camiloromero01/Micro-Current-Measurement/Pruebas de laboratorio/Corriente_activa_medicion.jpeg

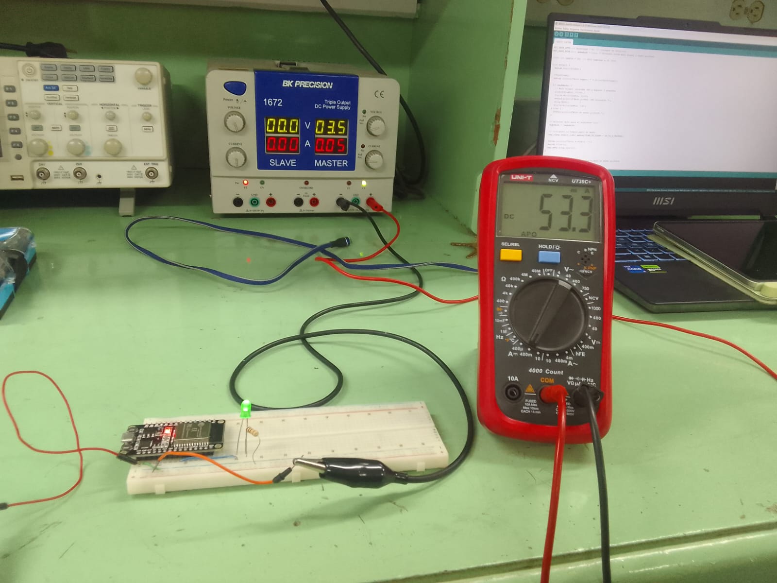
Pruebas de laboratorio/Corriente_activa_medicion.jpeg
