camiloromero01/Micro-Current-Measurement/Pruebas de laboratorio/Transmision_Bluetooth.jpeg

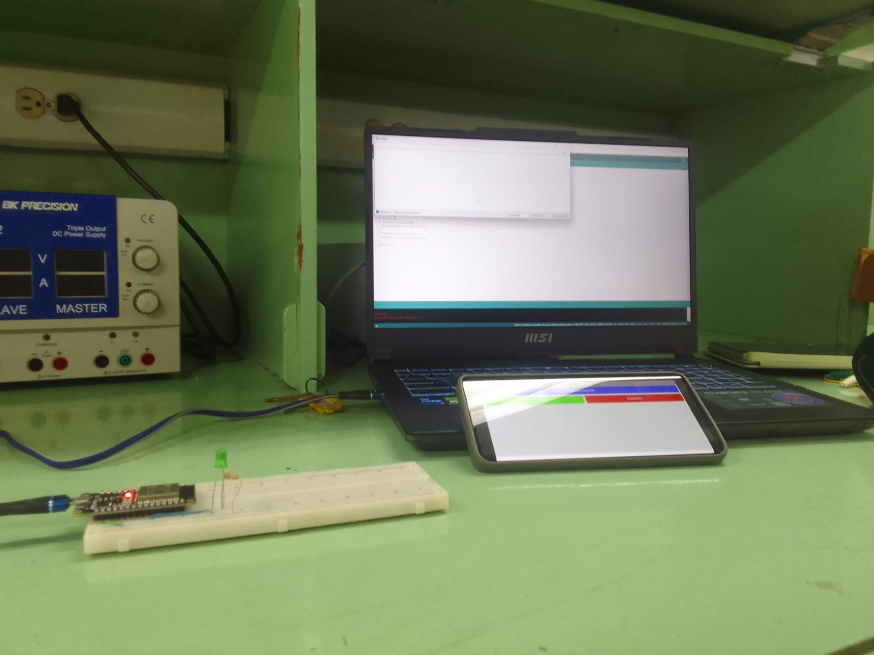
Pruebas de laboratorio/Transmision_Bluetooth.jpeg
