camiloromero01/Micro-Current-Measurement/README.md

# Micro-Current-Measurement
Este es un repositorio en el cual se encuantra toda la documentacion asociada al medidor de corriente, el sual fue diseñado para operar en tres rangos de medicion (Escala de micro amperios, mili amperios y autorango).
