camiloromero01/Micro-Current-Measurement/Informe/Readme

En esta carpeta se encuentra el informe resultante de realizar la construción del medidor de corriente
