camiloromero01/Micro-Current-Measurement/Datasheets/Readme

En esta carpeta se encuentran los datasheets de los componentes utilizados para el proyecto.
