camiloromero01/Micro-Current-Measurement/Evidencias fotograficas/Readme

Aca se encuentran las fotos de los esquematicos y partes del proyecto.
