camiloromero01/Micro-Current-Measurement/Archivos de simulacion/Readme

En esta carpeta se encuantran los archivos de simulación del proyecto
