camiloromero01/Micro-Current-Measurement/Evidencias fotograficas/consumo Compuera XOR activa.jpg

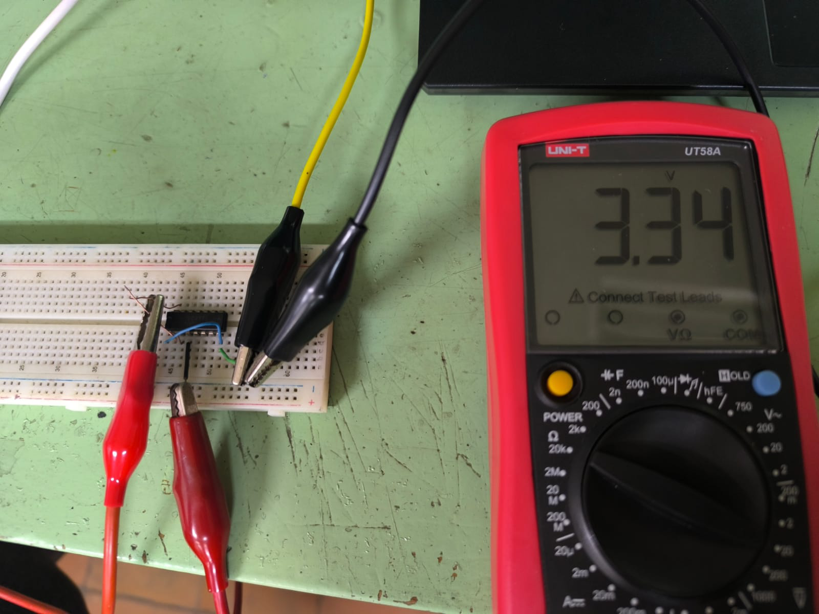
Evidencias fotograficas/consumo Compuera XOR activa.jpg
