camiloromero01/Micro-Current-Measurement/Evidencias fotograficas/consumo Compuera XOR en low.jpg

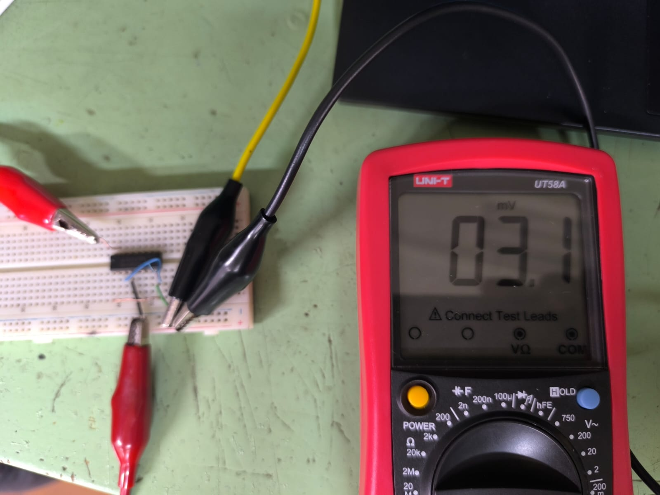
Evidencias fotograficas/consumo Compuera XOR en low.jpg
