camiloromero01/Micro-Current-Measurement/Evidencias fotograficas/Corriente ESP32 en estado activo.jpg

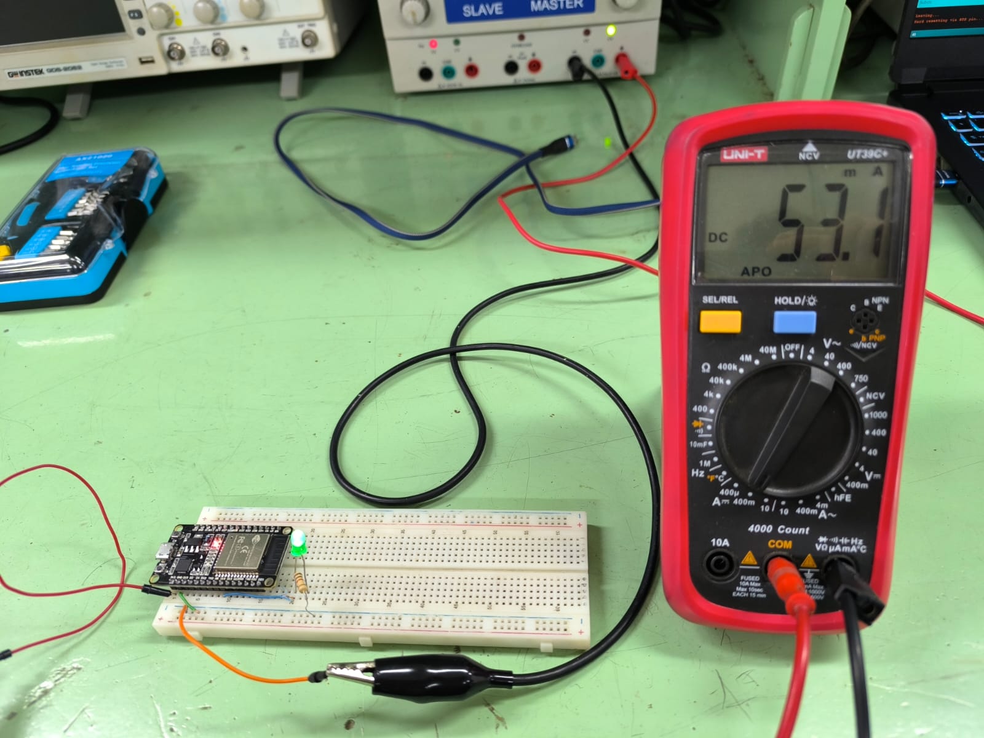
Evidencias fotograficas/Corriente ESP32 en estado activo.jpg
