camiloromero01/Micro-Current-Measurement/Evidencias fotograficas/Corriente ESP32 en sueño profundo.jpg

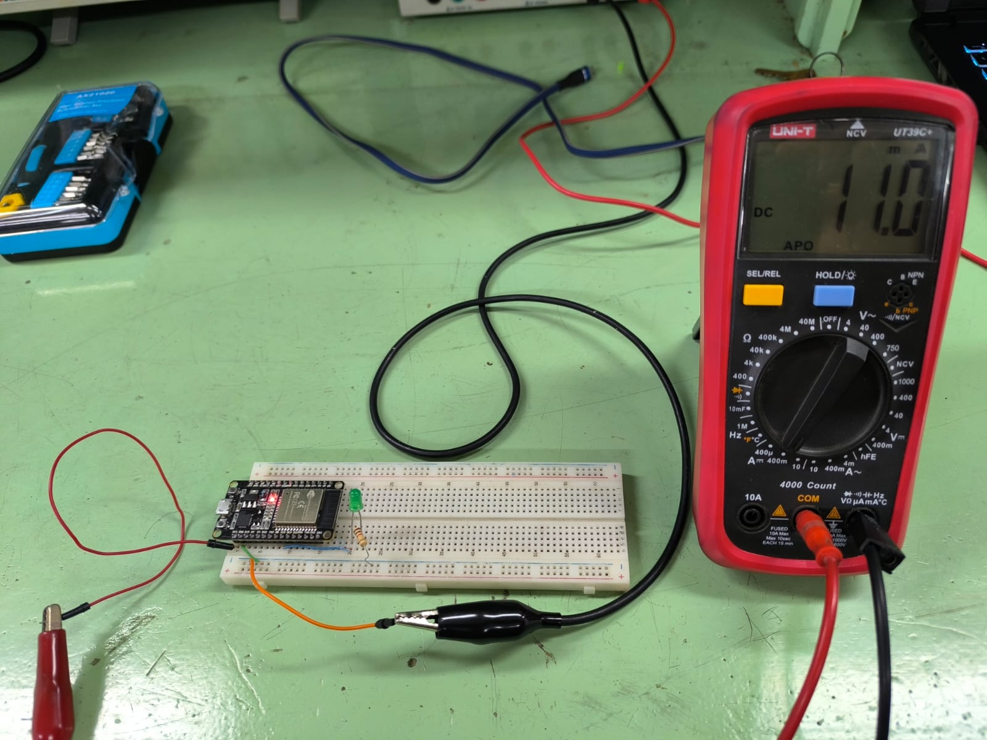
Evidencias fotograficas/Corriente ESP32 en sueño profundo.jpg
