camiloromero01/Micro-Current-Measurement/PCB/Vista2D.png

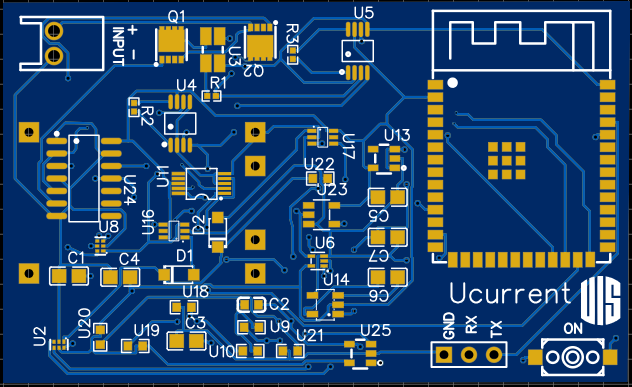
PCB/Vista2D.png
