camiloromero01/Micro-Current-Measurement/PCB/Vista3Dinferior.png

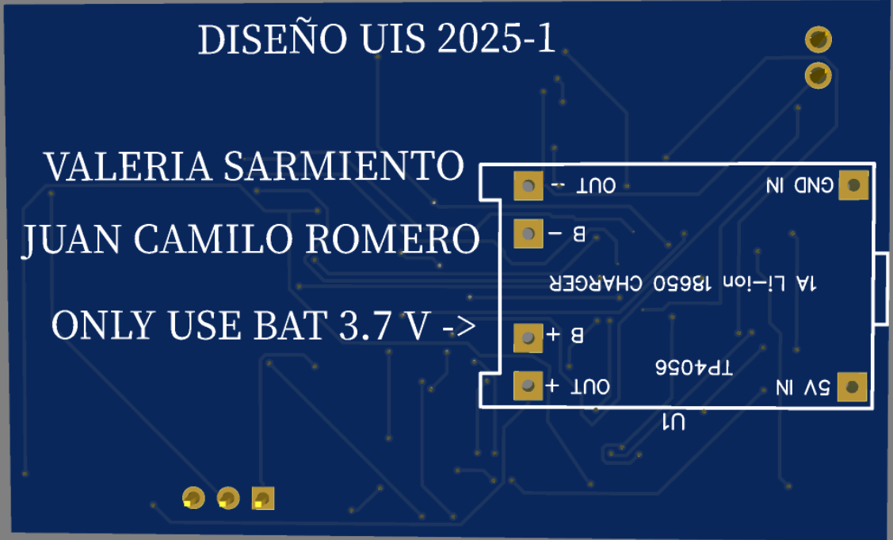
PCB/Vista3Dinferior.png
