camiloromero01/Micro-Current-Measurement/PCB/Vista3Dsuperior.png

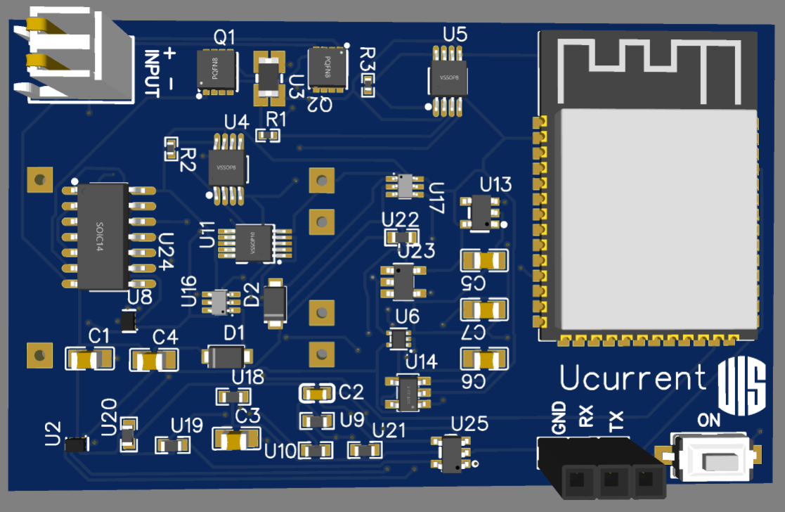
PCB/Vista3Dsuperior.png
