camiloromero01/Micro-Current-Measurement/Pruebas de laboratorio/Readme

En esta carpeta se encuentran las pruebas de laboratorio realizada a algunos componentes del medidor de corriente
