camiloromero01/Micro-Current-Measurement/PCB/Schematic_MICRO-AND-MILI-CURRENT-MEASUREMENT_2025-05-25.png

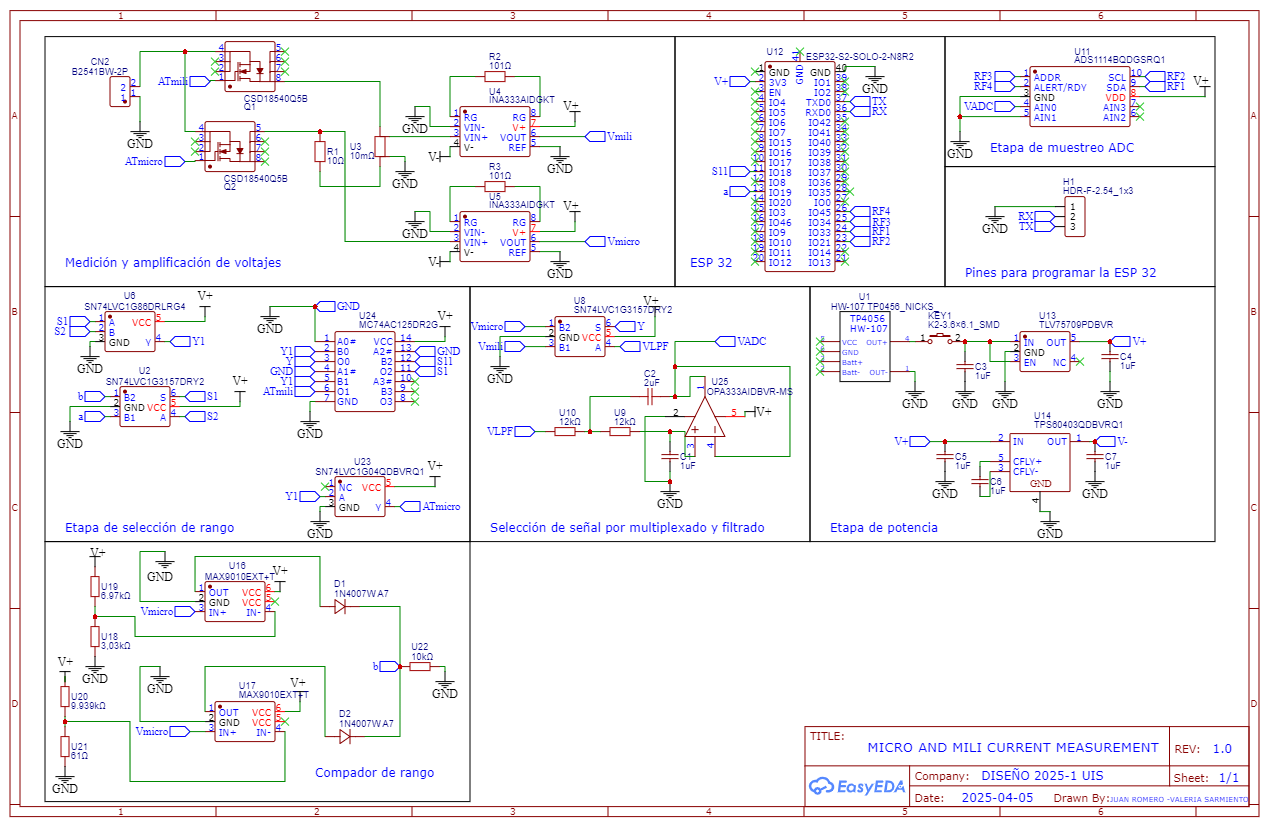
PCB/Schematic_MICRO-AND-MILI-CURRENT-MEASUREMENT_2025-05-25.png
