camiloromero01/Micro-Current-Measurement/Pruebas de laboratorio/Corriente_sueño_medicion.jpeg

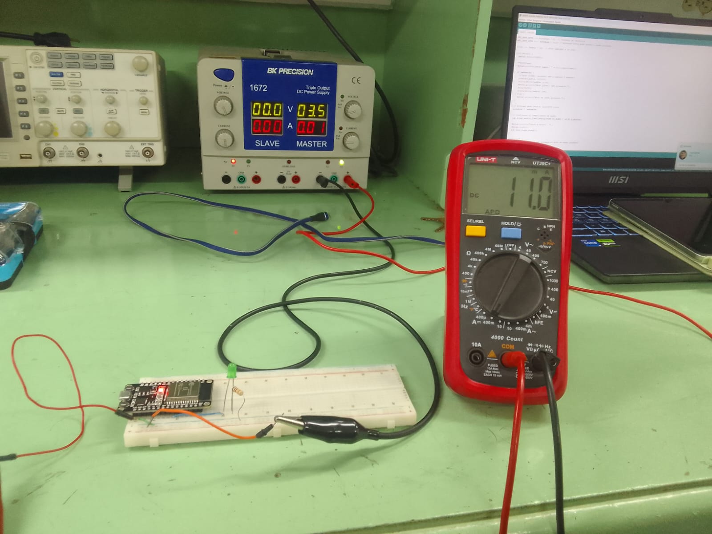
Pruebas de laboratorio/Corriente_sueño_medicion.jpeg
