camiloromero01/Micro-Current-Measurement/Pruebas de proteccion del circuito/Corriente en sentido positivo.png

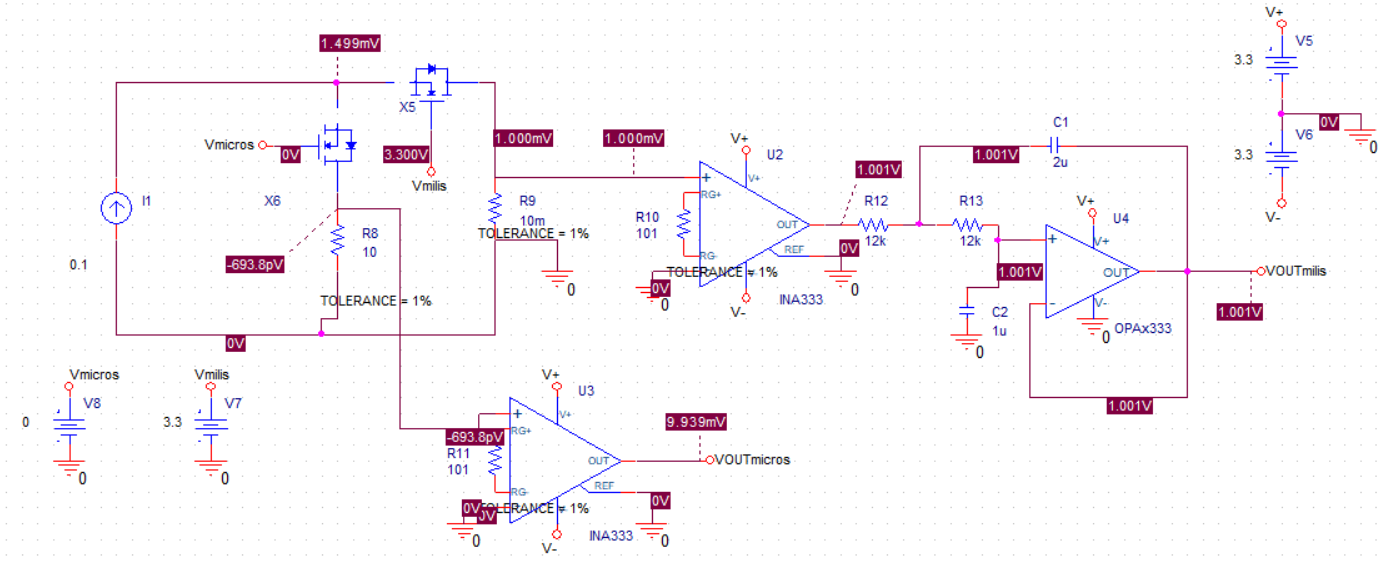
Pruebas de proteccion del circuito/Corriente en sentido positivo.png
