camiloromero01/Micro-Current-Measurement/Pruebas de proteccion del circuito/Corriente negativa.png

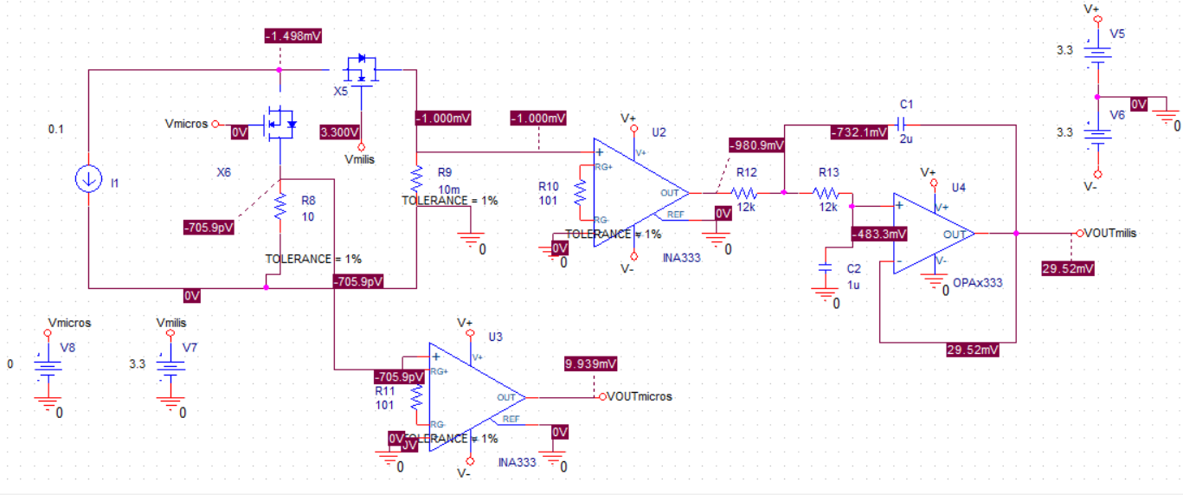
Pruebas de proteccion del circuito/Corriente negativa.png
