camiloromero01/Micro-Current-Measurement/Pruebas de proteccion del circuito/Indicador de corriente en sentido contrario.png

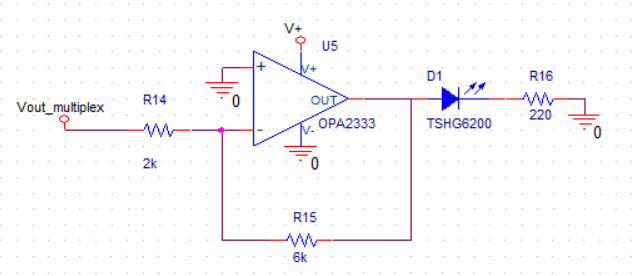
Pruebas de proteccion del circuito/Indicador de corriente en sentido contrario.png
