camiloromero01/Micro-Current-Measurement/Evidencias fotograficas/Schematic_MICRO-AND-MILI-CURRENT-MEASUREMENT.pdf

## Etapa de muestreo ADC

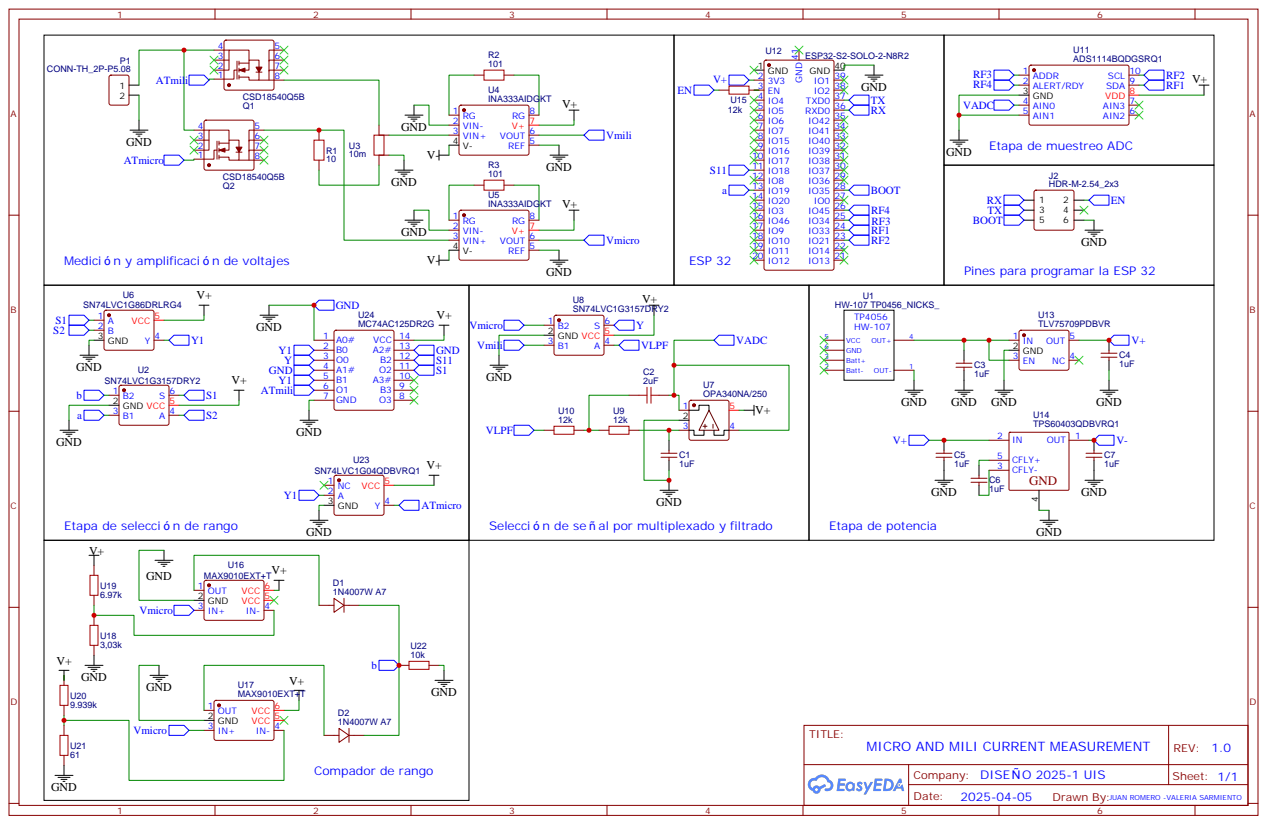
[picture p64: page 1]

Medici n y amplificaci n de voltajes

Pines para programar la ESP 32

Drawn By:JUAN ROMERO -VALERIA SARMIENTO
