camiloromero01/Micro-Current-Measurement/(commit log)

2025-04-03 Codigos ESP 32
    En esta carpeta se encuentran los codigos para programar la ESP 32 para que funcione dentro del circuito de medición de corriente, asi como los codigos para realizar las pruebas de caracterización de la placa ( modo sueño profundo y emulacion de trasmision de datos con el aplicativo).
2025-04-11 Codigo transmisión de datos
2025-05-24 Add files via upload
    Se encuentra el código de la ganancia del ADC
2025-05-25 Add files via upload
    Código que prueba la aplicación de APP Inventor y envía valores aleatorios de la corriente
2025-05-25 Add files via upload
    Es un código propuesto que todavía no ha sido probado, pero que contiene partes claves en la programación de nuestro medidor
2025-05-25 Update CodigoPropuestoCompleto.ino
    Se añadió una corrección para que corrigiera el offset de acuerdo al tipo de medición
    [CodigoPropuestoCompleto.ino]
2025-05-25 Update LecturaADC.ino
    Se modifico el código de 2028 V a 1024 V para mejorar la precisión
2025-05-25 Add files via upload
    Vistas en 3D y 2d del medidor de corriente desarrollado
